Neumi/lumicomm/documentation/images/round_edges_signal.png

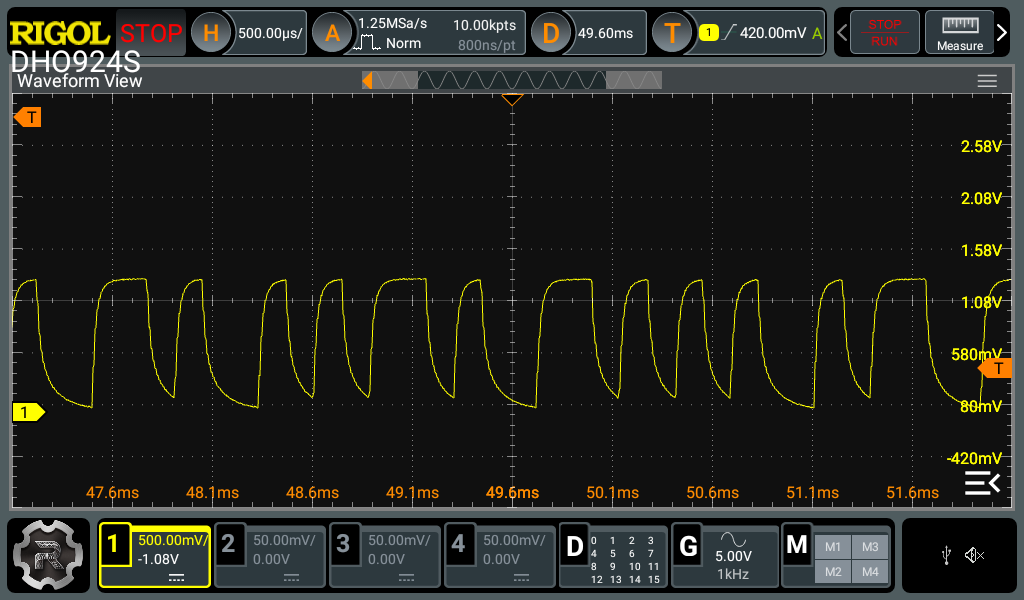
documentation/images/round_edges_signal.png
