Neumi/lumicomm/documentation/images/sharp_edges_signal.png

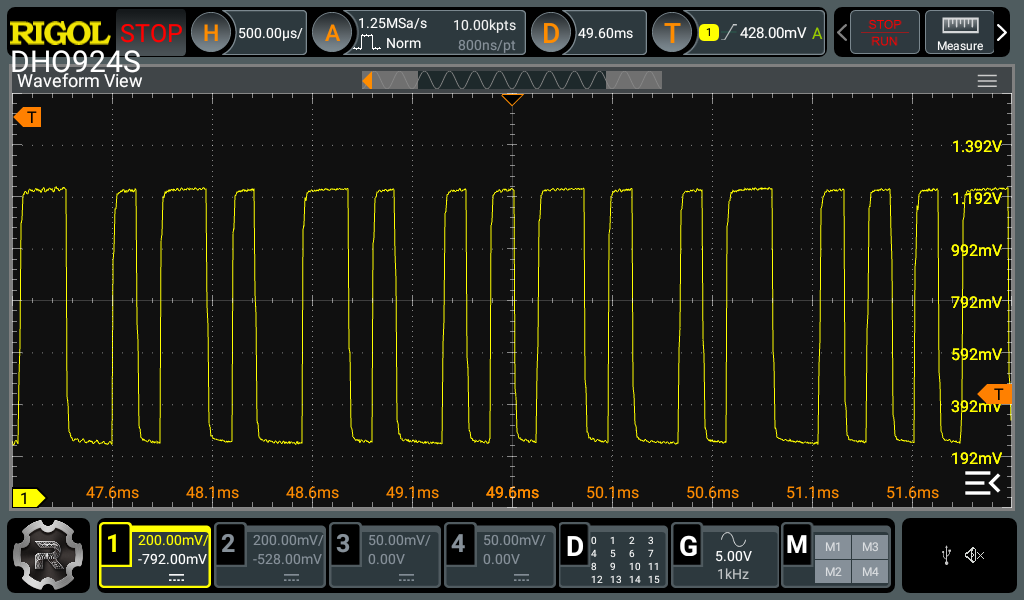
documentation/images/sharp_edges_signal.png
